T40O0/ADXL355_SPI_M5_SD_RainGauge/README.md

# MEMS Rain Gauge  
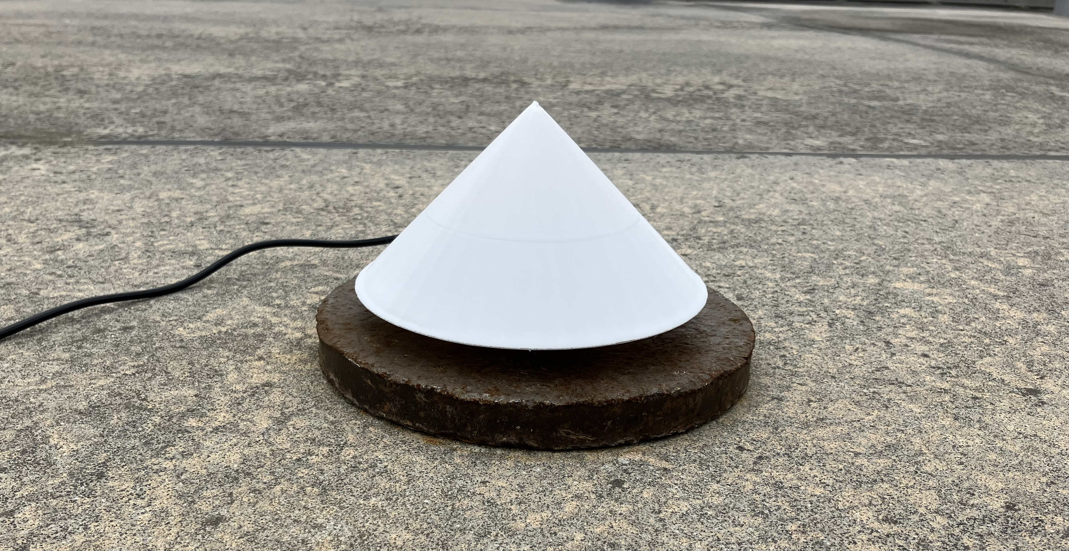
[picture p1: images/1.JPG]

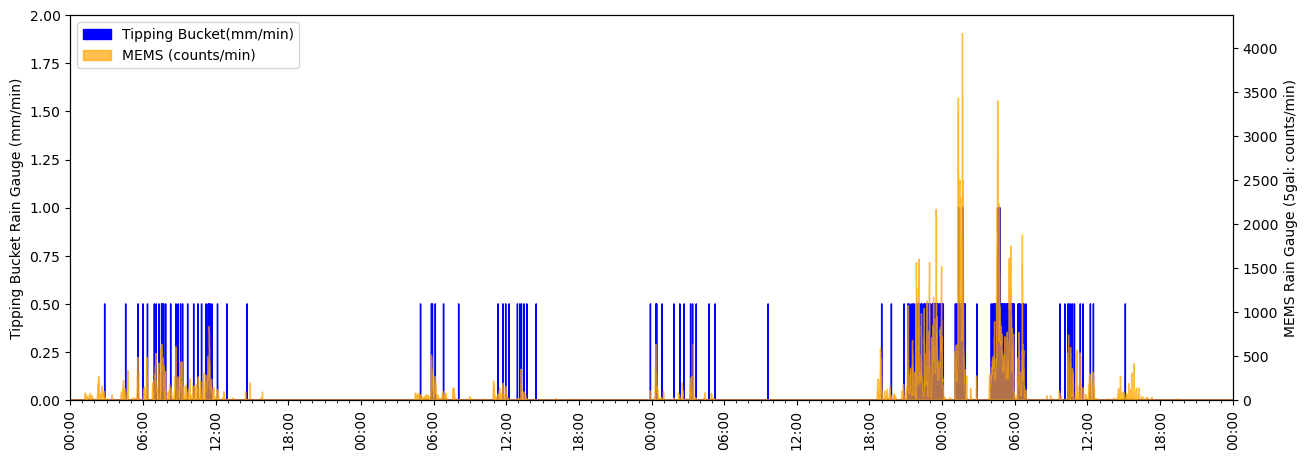
[picture p2: images/2.png]


## Prerequisite
 - ADXL355 ([EVAL-ADXL355-PMDZ](https://www.analog.com/en/products/adxl355.html#product-overview))
 - [M5Stack Tough](https://docs.m5stack.com/en/core/tough)
 - [hat](https://github.com/T40O0/ADXL355_SPI_M5_SD_FIR/blob/main/3D_model/hat.stl)
 - [modified version](https://github.com/T40O0/M5_ADXL355/tree/M5) of [plasmapper/adxl355-arduino](https://github.com/plasmapper/adxl355-arduino)  
Hats off to PL.

## Features
 - Cost-effective: It can be built for around €100.
 - Tracking: counts samples exceeding four preset thresholds (5 / 10 / 20 / 30 gal) at three rates per minute:
   - **100 Hz**: decimated 1-of-2 from the 5 ms (200 Hz) outer loop on the last drained FIFO sample (ESP32-clock-aligned, kept for backward compatibility with the empirical rainfall formula below).
   - **1 kHz**: every 4th FIFO sample inside the drain loop (ADXL-clock-aligned). Natural disdrometer rate where each ~5 ms raindrop impulse contributes ~5 counts.
   - **4 kHz**: every ADXL355 sample, drained from the on-chip FIFO each 5 ms outer-loop iteration (~20 triplets per drain, well below the 32-triplet FIFO limit so no samples are lost). Captures sub-millisecond raindrop impulses that lower-rate subsampling may miss.
 - Rainfall conversion: multiplies the per-minute 100 Hz exceedance frequency by an empirical coefficient to estimate rainfall in mm.
 - Local storage: saves a single CSV per day on a TF (microSD) card (`/YYYYMMDD.csv`), one row per minute, 13 columns (`datetime` + 4 thresholds × 3 rates).
 - Dual-core FreeRTOS pipeline (TaskRead on PRO_CPU, TaskSave on APP_CPU) decouples sampling from SD I/O.
 - Per-minute LCD status panel (5 s on, ~55 s off) showing date/time, both count rates per threshold, OK/DROP, and an `N4k` diagnostic (~240000 expected per minute = ODR 4000 × 60 s).
 - Built-in Wi-Fi AP + FTP server for data retrieval (no SD card removal required).
 - Maintenance-free: prevents clogging issues caused by volcanic ash, which commonly affect traditional tipping bucket rain gauges.

## Installation
 - Wire and mount the ADXL355 the same as the [MEMS Seismometer](https://github.com/T40O0/ADXL355_SPI_M5_SD_FIR).
 - Upload this sketch to the M5Stack Tough using the Arduino IDE.

## How to start
On power-on, a startup screen with four options is shown for 30 seconds. Tap a button, or wait for the timer to elapse.

1. **Wi-Fi Setting** - SmartConfig (set or change the Wi-Fi access point), then NTP sync of the RTC.
2. **Reset RTC** - Connect to a saved Wi-Fi access point and resync the RTC via NTP.
3. **Manual Set** - Set RTC year/month/day/hour/minute/second on the touch screen (no Wi-Fi needed).
4. **Data Dump** - Start a SoftAP + FTP server. Connect a PC to the AP and pull files via Explorer.

After any of the above (or after the 30 second timeout), measurement begins at the next RTC second `00`.

## Note
 - In my testing area, rainfall estimates using the following coefficients gave R<sup>2</sup> = 0.97 against hourly rainfall (mm/h) from a tipping bucket rain gauge located 20 meters away. The coefficients were calibrated against the **100 Hz** column.
   - 5 gal exceedance frequency × 0.0002281 (mm)
   - 10 gal exceedance frequency × 0.0004399 (mm)
 - Data are recorded one row per minute. Rows can be aggregated to estimate rainfall every 10 minutes, hourly, etc.
 - **Sampling**: ADXL355 ODR=4000 Hz, internal LPF -3 dB @ 1000 Hz. The read task wakes every 5 ms (200 Hz outer loop) and drains the on-chip FIFO (~20 triplets per wake). Inside the drain loop, every sample feeds the 4 kHz exceedance count and every 4th sample feeds the 1 kHz count (both ADXL-clock-aligned). After the drain, the last drained sample feeds the 100 Hz count every 2nd outer iteration (ESP32-clock-aligned). All three are decimations (no anti-alias filter beyond the sensor's built-in LPF) and written every minute.
 - Why three rates: the 100 Hz column is kept so existing rainfall coefficients still apply. The 1 kHz column gives a natural "one count per raindrop scale" (each ~5 ms impulse contributes ~5 counts). The 4 kHz column captures sub-millisecond impulses that 1 kHz subsampling may miss. Theoretical ratios are 4 : 10 : 40 (4kHz : 1kHz : 100Hz scaled to a common base).
 - Aliasing is allowed by design - only threshold counts matter, not spectra. For frequency analysis, see the [MEMS Seismometer](https://github.com/T40O0/ADXL355_SPI_M5_SD_FIR) instead.
 - **CSV format**: `datetime, n100Hz>=5gal, n100Hz>=10gal, n100Hz>=20gal, n100Hz>=30gal, n1kHz>=5gal, n1kHz>=10gal, n1kHz>=20gal, n1kHz>=30gal, n4kHz>=5gal, n4kHz>=10gal, n4kHz>=20gal, n4kHz>=30gal`.
 - **Serial debug output**: the `>=5 gal` 100 Hz exceedance count is printed on Serial at each 100 Hz tick when `#define ENABLE_SERIAL_SAMPLES 1` at the top of the sketch. Default is `0` (disabled). Enable only for triggering / threshold-tuning checks.
 - **RTC year range**: measurements only start when the RTC year is in 2026..2099. Edit `setup()` if needed.
 - **NTP setup**: edit the defines near the top of the sketch to fit your environment.  
   `#define NTP_TIMEZONE  "your zone"`  
   `#define NTP_SERVER1   "your server1"`  
   `#define NTP_SERVER2   "your server2"`  
   `#define NTP_SERVER3   "your server3"`
 - **Wi-Fi setup (first time / new access point)**: choose **Wi-Fi Setting** on the startup screen, then use the *SmartConfig ESP* or *ESP Touch* app on your phone to push the SSID/password.
 - **Manual RTC**: use **Manual Set** when no Wi-Fi is available. A 10-second confirmation screen is shown before measurement begins.
 - **Data Dump (FTP)**: choose **Data Dump** on the startup screen. The device acts as a SoftAP (`SSID: M5-SEISMO / PASS: m5seismo`, identical to the [MEMS Seismometer](https://github.com/T40O0/ADXL355_SPI_M5_SD_FIR) sketch so a single saved Wi-Fi profile works for both). Connect a PC to the AP, then use a dedicated FTP client (**WinSCP**, **FileZilla**, or a web browser) at `ftp://m5:m5@192.168.4.1` to copy files. Tap the on-screen **Reset** button to return to the startup screen.
   - **Avoid Windows Explorer for the FTP transfer.** Explorer's built-in FTP shares the Internet Explorer cache and tends to keep stale copies of files across sessions, so a freshly appended row may not appear in the downloaded CSV even though the SD card itself is up to date. WinSCP / FileZilla / browsers fetch the current file every time and do not have this issue.
 - A "[hat](https://github.com/T40O0/ADXL355_SPI_M5_SD_FIR/blob/main/3D_model/hat.stl)" is required.
   - [x] Blocks sunlight and protects the LCD.
   - [x] Falling volcanic ash is washed away by rain.
 - Do not submerge the case in water or other liquids.
 - For more information, see [MEMS Seismometer](https://github.com/T40O0/ADXL355_SPI_M5_SD_FIR).

## Licence
This project bundles components from multiple sources, each under its own licence:
 - **ADXL355 driver code**: based on [plasmapper/adxl355-arduino](https://github.com/plasmapper/adxl355-arduino) (PL) - see the upstream repository for its licence terms.
 - **All other original work in this repository** (sketch code, 3D models, etc.): MIT licence - see the [LICENSE file](LICENSE) for details.

When redistributing or modifying this project, please honour each component's respective licence.
