T40O0/ADXL355_SPI_M5_SD_RainGauge/(commit log)

2026-04-06 Keep I2C connection with the RTC
2026-05-07 RainGauge: align with FIR companion sketch
    Bring the rain-gauge sketch up to parity with the seismometer:
    - Replace the legacy 3-button startup with a 4-button menu
    (Wi-Fi Setting / Reset RTC / Manual Set / Data Dump).
    - Add a touchscreen Manual Set RTC flow for offline deployments
    (no Wi-Fi required), sharing a 10-second confirmation screen with
    the NTP-based Reset RTC path.
    - Replace the previous WebServer + on-the-fly ZIP download with a
    self-contained minimal FTP server (port 21 control + 50000 PASV
    data) that works reliably with Windows Explorer.
    - Add openSDFileSafe() to retry SD opens and remount on persistent
    failure, removing the previous while(1) hang on TF errors.
    - D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
    [ADXL355_SPI_M5_SD_RainGauge.ino]
2026-05-08 RainGauge: FIFO-driven 4 kHz threshold counts and M5-SEISMO SoftAP
    - Switch ADXL355 read from data-register polling to on-chip FIFO drain
    (clearFifo at startup, getAccelerationsFromFifo each iteration).
    - Outer loop now 200 Hz / 5 ms; SLOW_DIV=2 gates the 100 Hz threshold
    tick. FIFO holds 32 triplets / 8 ms at ODR=4000 Hz, so 5 ms drain
    has comfortable margin and the 4 kHz exceed count is loss-free.
    - Add 4 kHz threshold counts (binary4k0..3) alongside the existing
    100 Hz counts; disable the running sum (AccCount0..3) in both
    computation, CSV body/header, and the LCD panel.
    - CSV is now 9 columns: datetime + n100Hz>=Ngal x4 + n4kHz>=Ngal x4.
    - TaskSave per-minute LCD panel: fillScr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
2026-05-08 RainGauge: tidy comments, fix README sampling description
    - Drop redundant multi-line comments around adxl355.clearFifo(), the
    setup() timeout catch-up call, the menu-UI fillScreen, and the
    display-snapshot publish block.
    - Collapse slowTick's two-line trailing comment into a single line.
    - README Features + Sampling note: correct stale "1 ms outer loop /
    1-of-10 decimation" wording to match the actual 5 ms (200 Hz) outer
    loop with SLOW_DIV=2, and note that the 5 ms drain interval is well
    below the 32-triplet FIFO limit so the 4 kHz count is loss-free.
    [ADXL355_SPI_M5_SD_RainGauge.ino]
2026-05-08 RainGauge: add 1 kHz threshold path, hybrid 200 Hz outer, fix Manual_Set weekday
    - Add 1 kHz exceedance count: tick driven inside the FIFO drain loop
    (every 4th sample = 4 kHz / 4, ADXL-clock-aligned). Decimation is
    independent of the outer-loop rate.
    - Restore outer loop to 200 Hz / 5 ms drain interval now that the
    1 kHz tick is FIFO-driven. SLOW_DIV=2 keeps the 100 Hz tick at
    100 Hz, and the 5 ms drain leaves comfortable margin under the
    8 ms FIFO overflow limit. ~5x fewer outer-loop wakeups vs running
    the outer loop at 1000 Hz.
    - 100 Hz tick stays in the outer-loop scope (last_Acc, ESP32-clock-
    aligned) so the existing rainfall coefficient column keeps its
    high-precision a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
    [ADXL355_SPI_M5_SD_RainGauge.ino]
2026-05-08 RainGauge: Manual_Set long-press auto-repeat + comment cleanup
    - Manual_Set +/- buttons now auto-repeat after 400 ms of holding:
    ~7 Hz (REPEAT_SLOW) initially, accelerating to ~20 Hz (REPEAT_FAST)
    after 2 s. Repeat stops when the finger is lifted or dragged off
    the original button.
    - Comment cleanup: drop obvious one-line comments (// Initialize
    ADXL355 / // Start SD / // CSV header... etc.), shorten multi-line
    block comments around applyRtcAndConfirm, openSDFileSafe, the
    Sakamoto weekday computation, the dispatched flag rationale, the
    outer-loop / FIFO drain explanation, the N4k diagnostic, etc.
    [ADXL355_SPI_M5_SD_RainGauge.ino]
2026-05-08 RainGauge: power save by dimming the backlight between status panels
    TaskSave: bring the LCD backlight up only for the 5 s status panel and
    turn it off again for the remaining ~55 s of each minute. With
    SDWriteTime = 60 s the backlight is now ON ~8 % of the time vs.
    always-on previously, which dominates the device's current draw.
    Companion to the same change on the FIR sketch; data path is
    untouched.
